arcticlula/dumbledoor/dumbledoor/dumbledoor.kicad_sch

## KiCad design dumbledoor/dumbledoor.kicad_sch (2026-10-20, an earlier design)

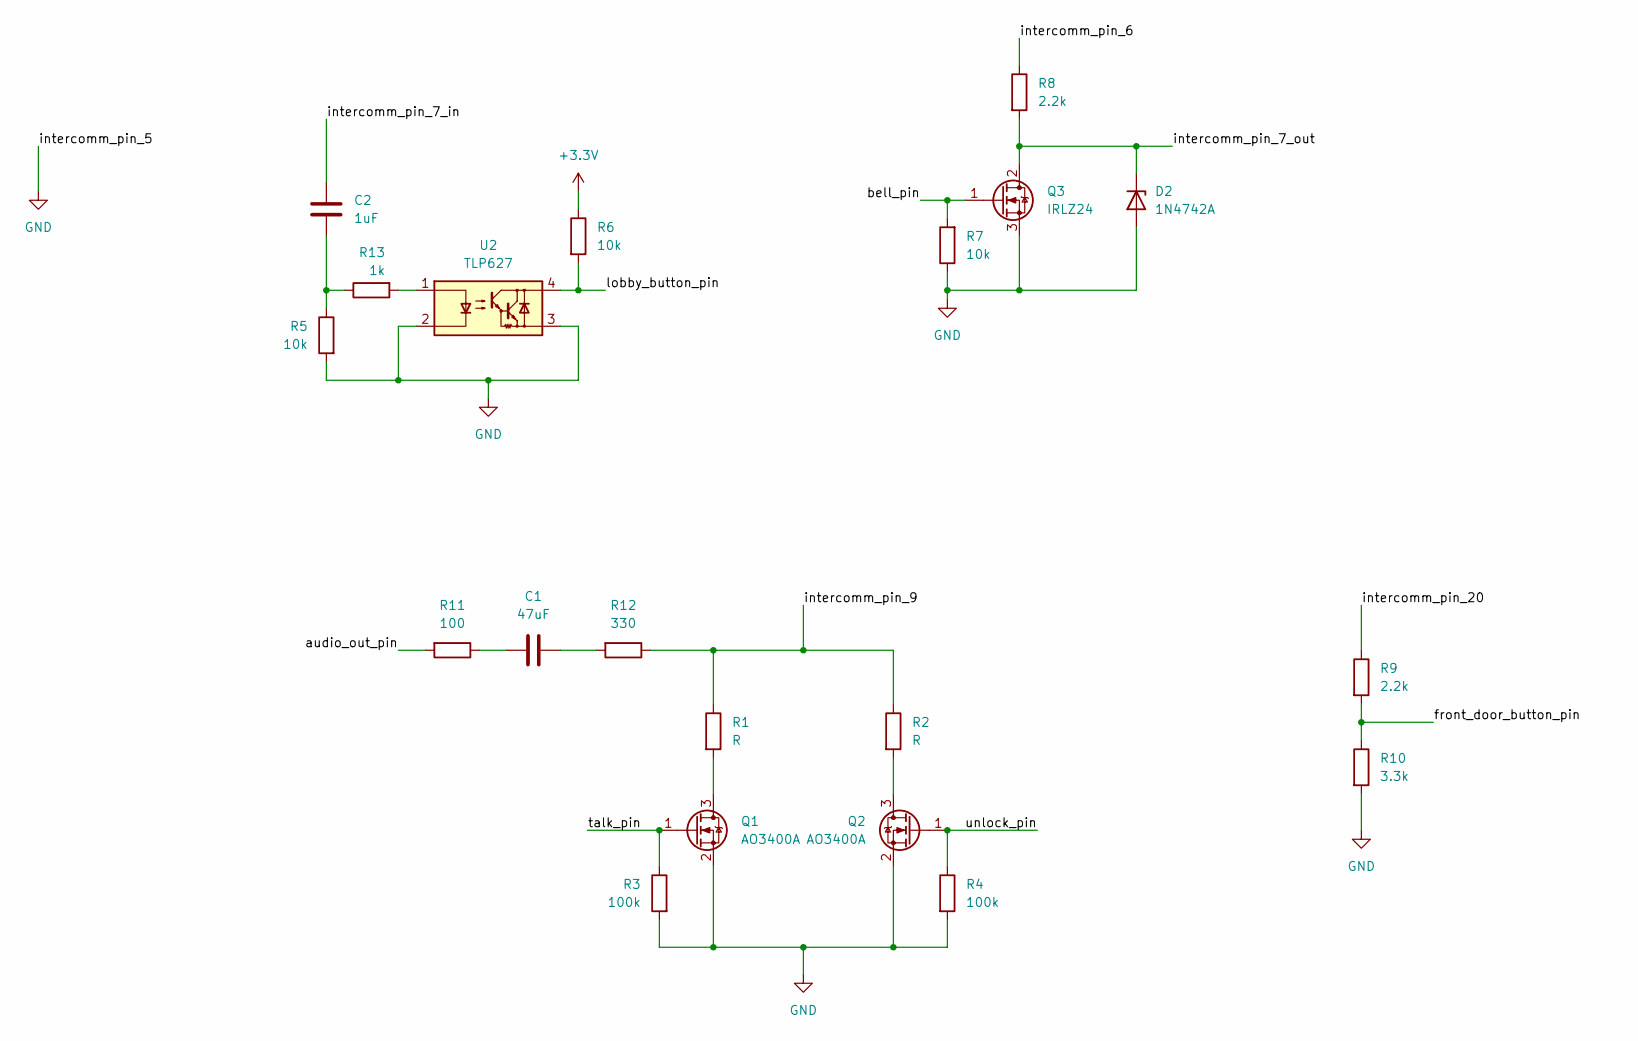
[picture p6: schematic dumbledoor.kicad_sch]

Parts:
C1: 47uF
C2: 1uF
D2: 1N4742A; D_DO-41_SOD81_P10.16mm_Horizontal
Q1, Q2: AO3400A; SOT-23
Q3: IRLZ24; TO-220-3_Vertical
R1, R2: R
R3, R4: 100k
R5, R6, R7: 10k
R8, R9: 2.2k
R10: 3.3k
R11: 100
R12: 330
R13: 1k
U2: TLP627; DIP-4_W7.62mm

Connections:
+3.3V: R6.1
GND: D2.2 (A), Q1.2 (S), Q2.2 (S), Q3.3 (S), R3.2, R4.2, R5.2, R7.1, R10.2, U2.2, U2.3
unnamed: C1.1, R11.1
unnamed: C1.2, R12.2
unnamed: C2.2, R5.1, R13.1
unnamed: Q1.3 (D), R1.2
unnamed: Q2.3 (D), R2.2
unnamed: R13.2, U2.1
audio_out_pin: R11.2
bell_pin: Q3.1 (G), R7.2
front_door_button_pin: R9.2, R10.1
intercomm_pin_6: R8.1
intercomm_pin_7_in: C2.1
intercomm_pin_7_out: D2.1 (K), Q3.2 (D), R8.2
intercomm_pin_9: R1.1, R2.1, R12.1
intercomm_pin_20: R9.1
lobby_button_pin: R6.2, U2.4
talk_pin: Q1.1 (G), R3.1
unlock_pin: Q2.1 (G), R4.1
