arcticlula/dumbledoor/(commit log)

2026-10-18 Dumbledoor: firmware, phone app, simulator and docs
    ESP-IDF firmware for a LOLIN S2 Mini on a BPT System 200 intercom: lobby
    call detection through the ADC, door release, a code of presses on the
    lobby button, a web app served at http://dumbledoor.local, signed
    commands, and remote access through an MQTT broker. Also the KiCad
    schematic, scope captures, the September 2025 Arduino sketches, a Node
    simulator of the device and its tests.
    [dumbledoor.kicad_pcb, dumbledoor.kicad_sch, partitions.csv]
2026-10-20 Lobby code from the app, admin-only state, presses held while the code is on
    - Admins can change the lobby code from the app, at home or through the
    broker; the presses travel sealed with the phone's key.
    - Phones paired from an ordinary link only get the open button: auto-open
    and mute are admin-only, the device sends them a short state, and on the
    broker each admin gets the full state sealed on .../state/<key id>.
    - While the lobby code is on, presses are held back until the code's gap
    passes, then one outcome goes out: open by code, code_fail with its
    pattern, or the rings. Auto-open waits for it too.
    - Docs: BPT System 200 manual review in docs/hardware.md (don't build the
    be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
    [api.c, api.h, door.c, door.h, events.h, keys.c, keys.h, remote.c]
2026-10-20 Schematic: KiCad 10, input and bell stage changes
    [dumbledoor.kicad_sch]
